Brightness248/BLEIron/CYD Display/Images/GUI_minimal_chart.jpg

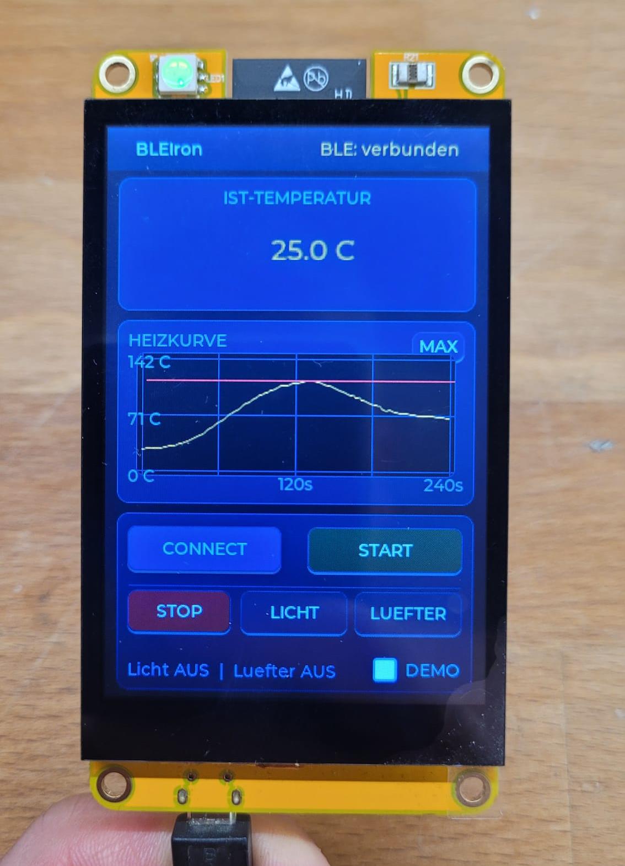
CYD Display/Images/GUI_minimal_chart.jpg
