Brightness248/BLEIron/CYD Display/Images/numpad.jpg

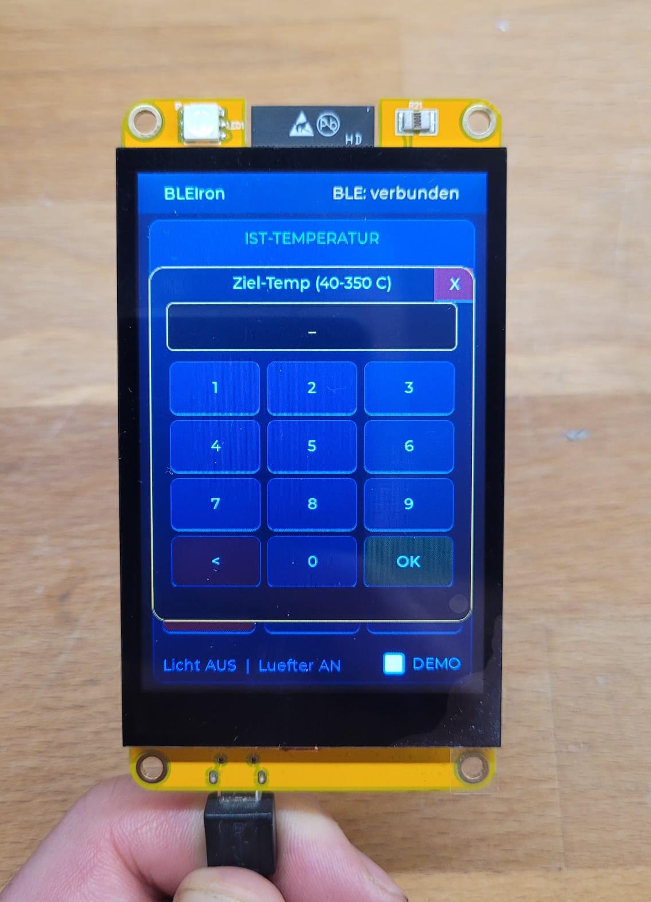
CYD Display/Images/numpad.jpg
