Brightness248/BLEIron/Images/Final2.jpg

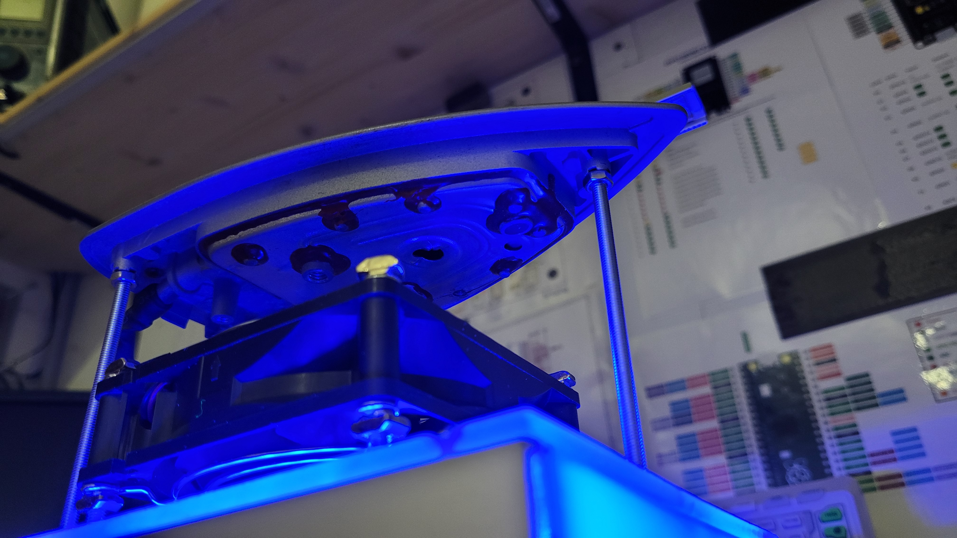
Images/Final2.jpg
