Brightness248/BLEIron/Images/Final.jpg

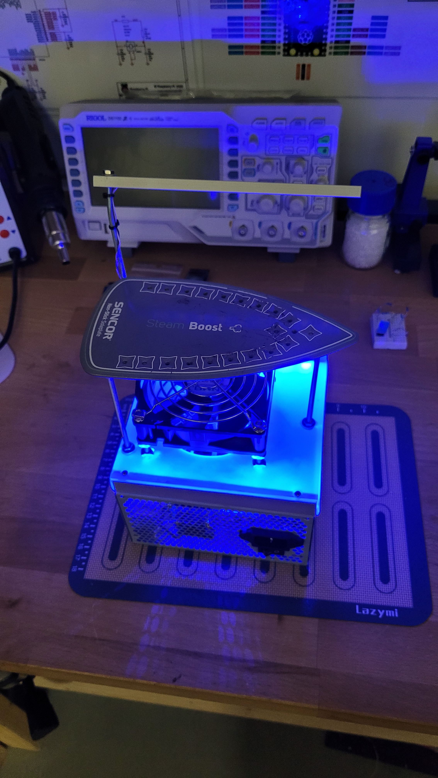
Images/Final.jpg
