Brightness248/BLEIron/Images/Prototype.jpg

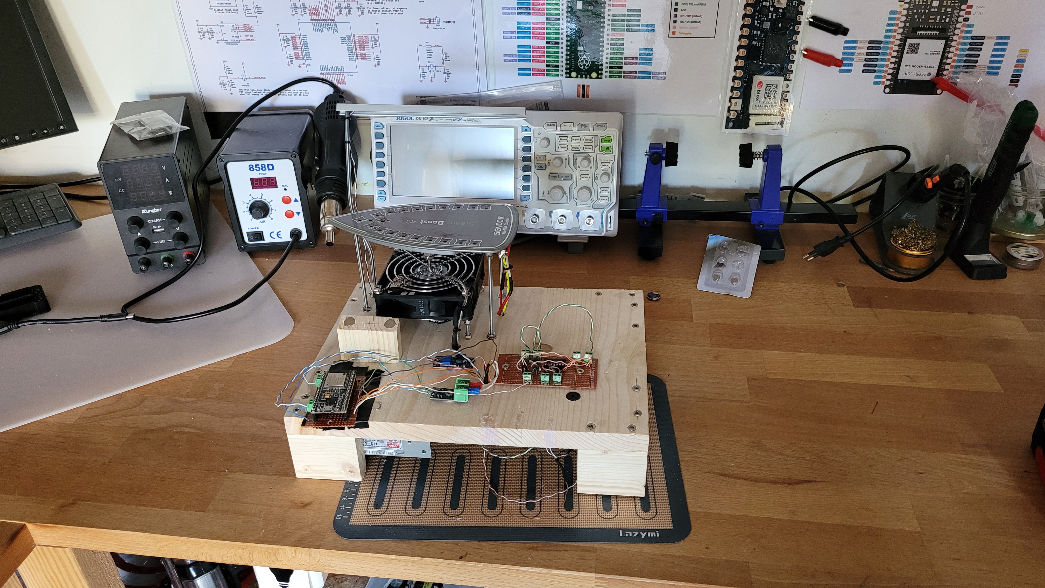
Images/Prototype.jpg
