Brightness248/BLEIron/Images/Screenshot_App.jpg

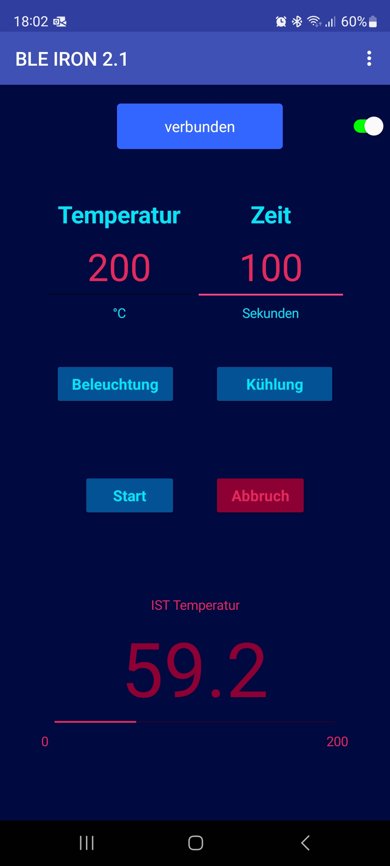
Images/Screenshot_App.jpg
