Brightness248/BLEIron/PCB/PCB_PCB_buegeleisen.png

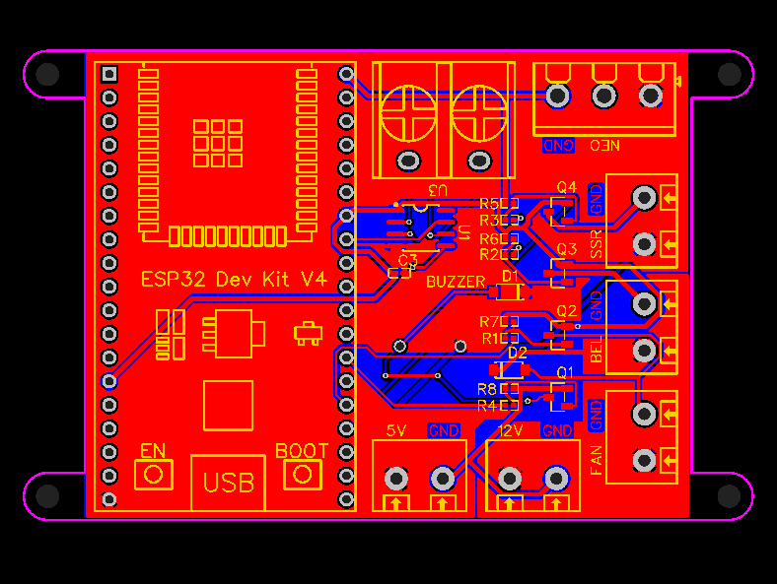
PCB/PCB_PCB_buegeleisen.png
