Brightness248/BLEIron/PCB/Schematic_buegeleisen.png

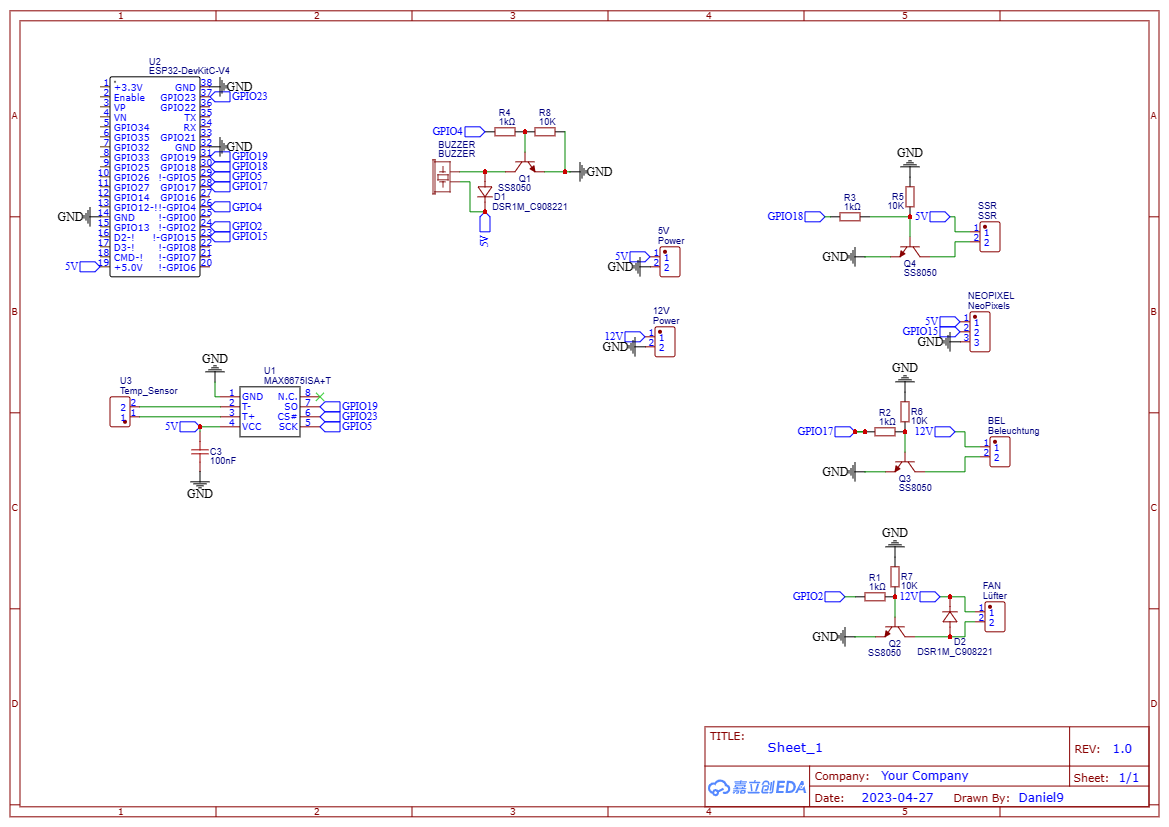
PCB/Schematic_buegeleisen.png
