Brightness248/BLEIron/Images/Rebuild_Mod.jpg

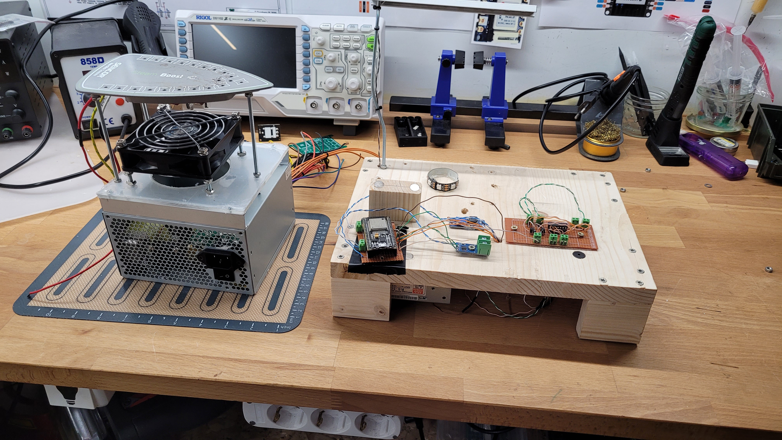
Images/Rebuild_Mod.jpg
