Brightness248/BLEIron/Images/Testing_new_version2.jpg

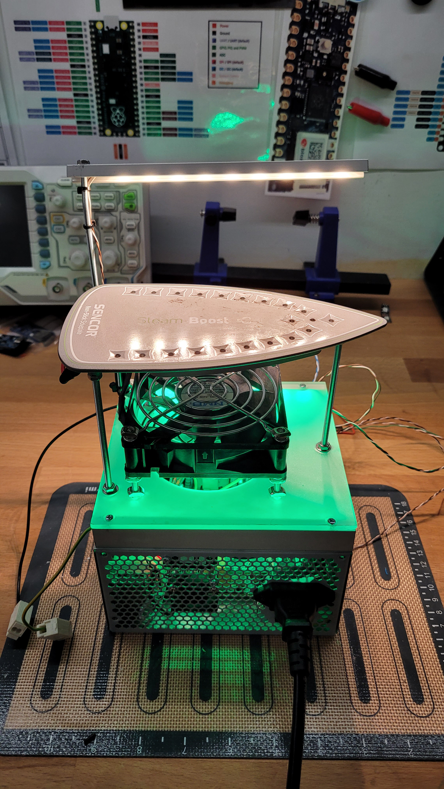
Images/Testing_new_version2.jpg
