Brightness248/BLEIron/Images/Testing_new_version.jpg

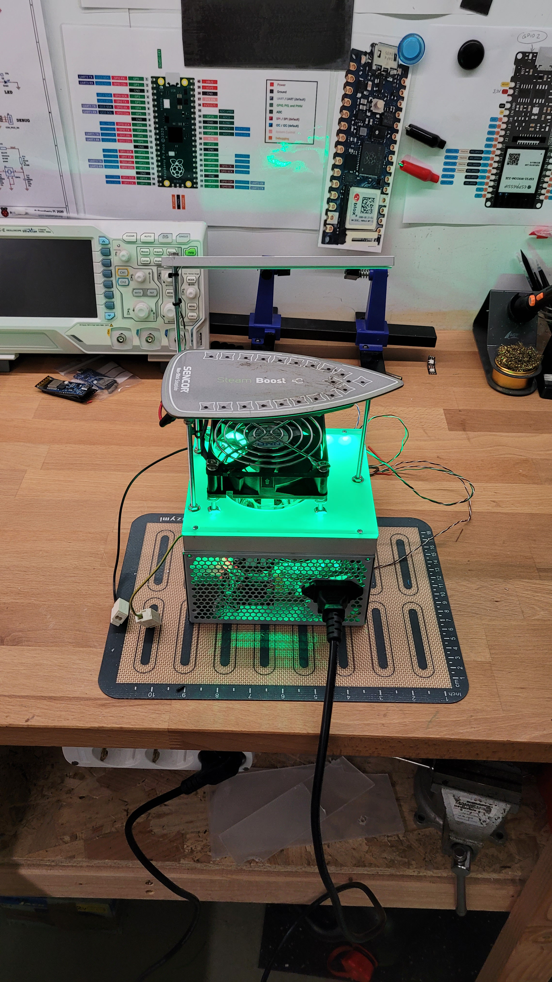
Images/Testing_new_version.jpg
