Brightness248/BLEIron/(commit log)

2026-04-29 vorbereitung auf PID Regler
2026-05-01 jetzt mit PID Regler
2026-05-05 bug gefixt. PID regelt jetzt besser
    [main_improved.py]
